chuckhardt/ParkTrainCrossingGuard/CrossingGuardElectSchematic v1.04.pdf

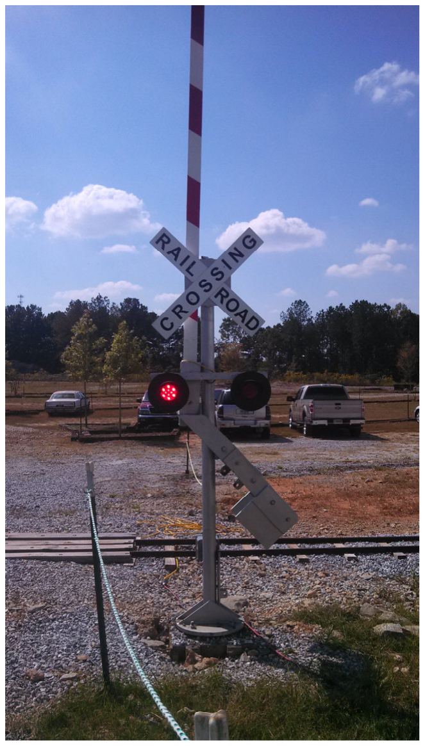
[picture p1: figure]

Park Train Crossing Guard Schematic

Chuck Hardt | 05/08/16 | Rev: 1.04

Crossing Guards – Actuator Motor Operational Notes:
1) The linear actuators that control the up/down movement of the gate arms are protected by limit switches. Power to the drive motor will automatically be cut when the actuator is fully extended (gate down), or fully retracted (gate up).
2) The gate motors are protected from over heating by built in thermal switches. These cannot be manually reset. If the motors overheat, they will automatically be disabled and remain in this state until they cool down. This could leave the gates in the “down” state.
3) The actuator motors are rated at a 10% duty cycle, and cannot run continuously. When lowering or raising the gates, the actuator motor will run for 13 seconds. Thus one complete up and down cycle will total 26 seconds (13 down, 13 up). For every down/up cycle the motors must cool for 260 seconds (4.33 mins).
4) Should the motor duty cycle be exceeded, the motors will be left in the up state, however the lights and bells will continue to function. Once the duty cycle is within normal limits, gate operations will continue.

Crossing Guards – Theory of Operation:
1) Upon first application of power, the control logic will reset. The microcontroller state machine will enter the “initialization” state. The lights and bells will be turned on, the gate motor direction relay will be set to “up”, and the gate motor power control relay will be activated for 13 seconds. After this time, all relays, lights, and bells will be deactivated.
2.0) The gate down/up cycle begins when the track occupation sensor line is pulled low. This line must remain low for 0.5 seconds in order for the micro controller to detect the change, and “trigger” the start of the cycle.
2.1) Upon the “trigger” event, the bells and lights will be activated 3 seconds prior to the gates being lowered.
2.2) The motor direction relay is then set to “down”.
2.3) The motor is activated for 13 seconds. Power to the gate motor will be interrupted (cut off), by the actuator limit switches when the gate arm reaches the max down position.
2.4) The gates will remain in the down position for 30 seconds.
2.5) Should the track occupation sensor “retrigger” during the down/up cycle, the gate down count will reset the 30 second count.
2.6) Once the gates have been down for the max duration, the gate motor control relay will be set to “up”.
2.7) The motor will then be activated for 13 seconds, which will drive the gates to the up position. Power to the gate motor will be interrupted (cut off), by the actuator limit switches when the gate arm reaches the max up position.
2.8) Once the gate arms are in the up position, the lights and bells will be turned off.

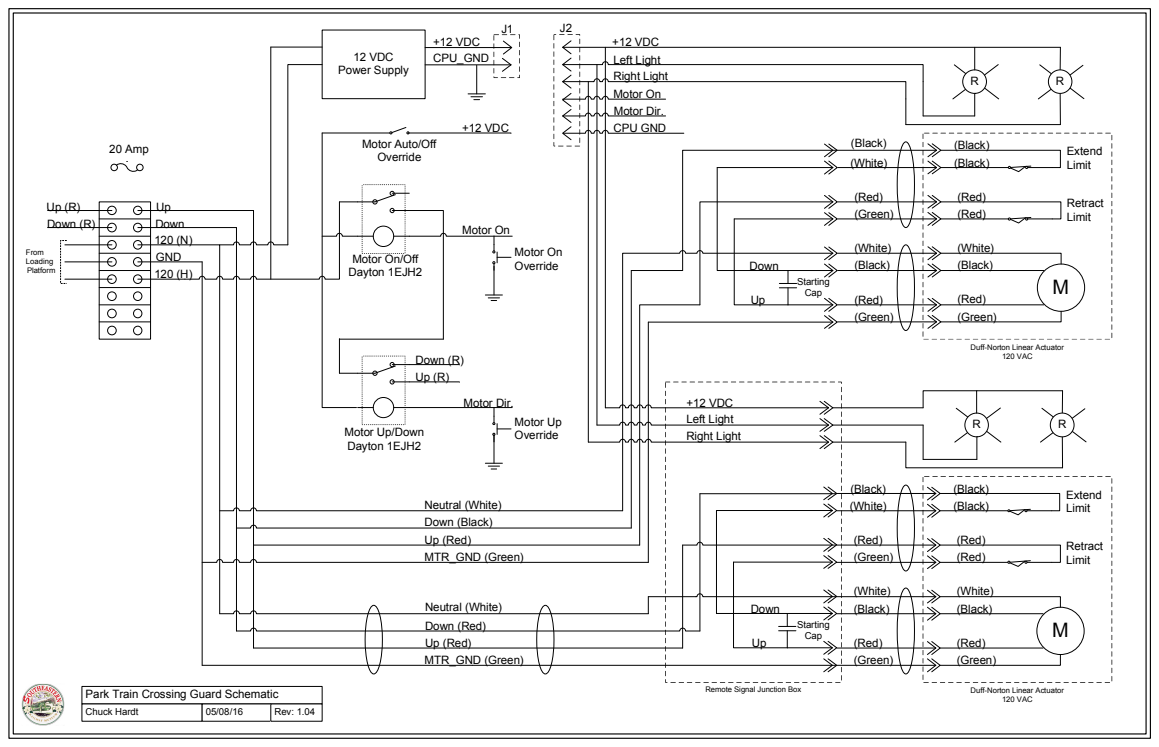
[picture p2: page 2]
120 VAC; (Green); (Red); (Black); (White); Extend Limit; Retract Limit; GND; Down; Neutral (White); Starting Cap; MTR_GND (Green); Down (Black); Up (Red); 12 VDC Power Supply; +12 VDC CPU_GND; +12 VDC; CPU GND; Left Light Right Light; Motor On Override; Motor Up Override; Motor On; Motor Dir.; 20 Amp; Down (Red); Down (R); From Loading Platform

Motor Auto/Off
Override

Motor On/Off
Dayton 1EJH2

Duff-Norton Linear Actuator

Motor Up/Down

Park Train Crossing Guard Schematic

Remote Signal Junction Box

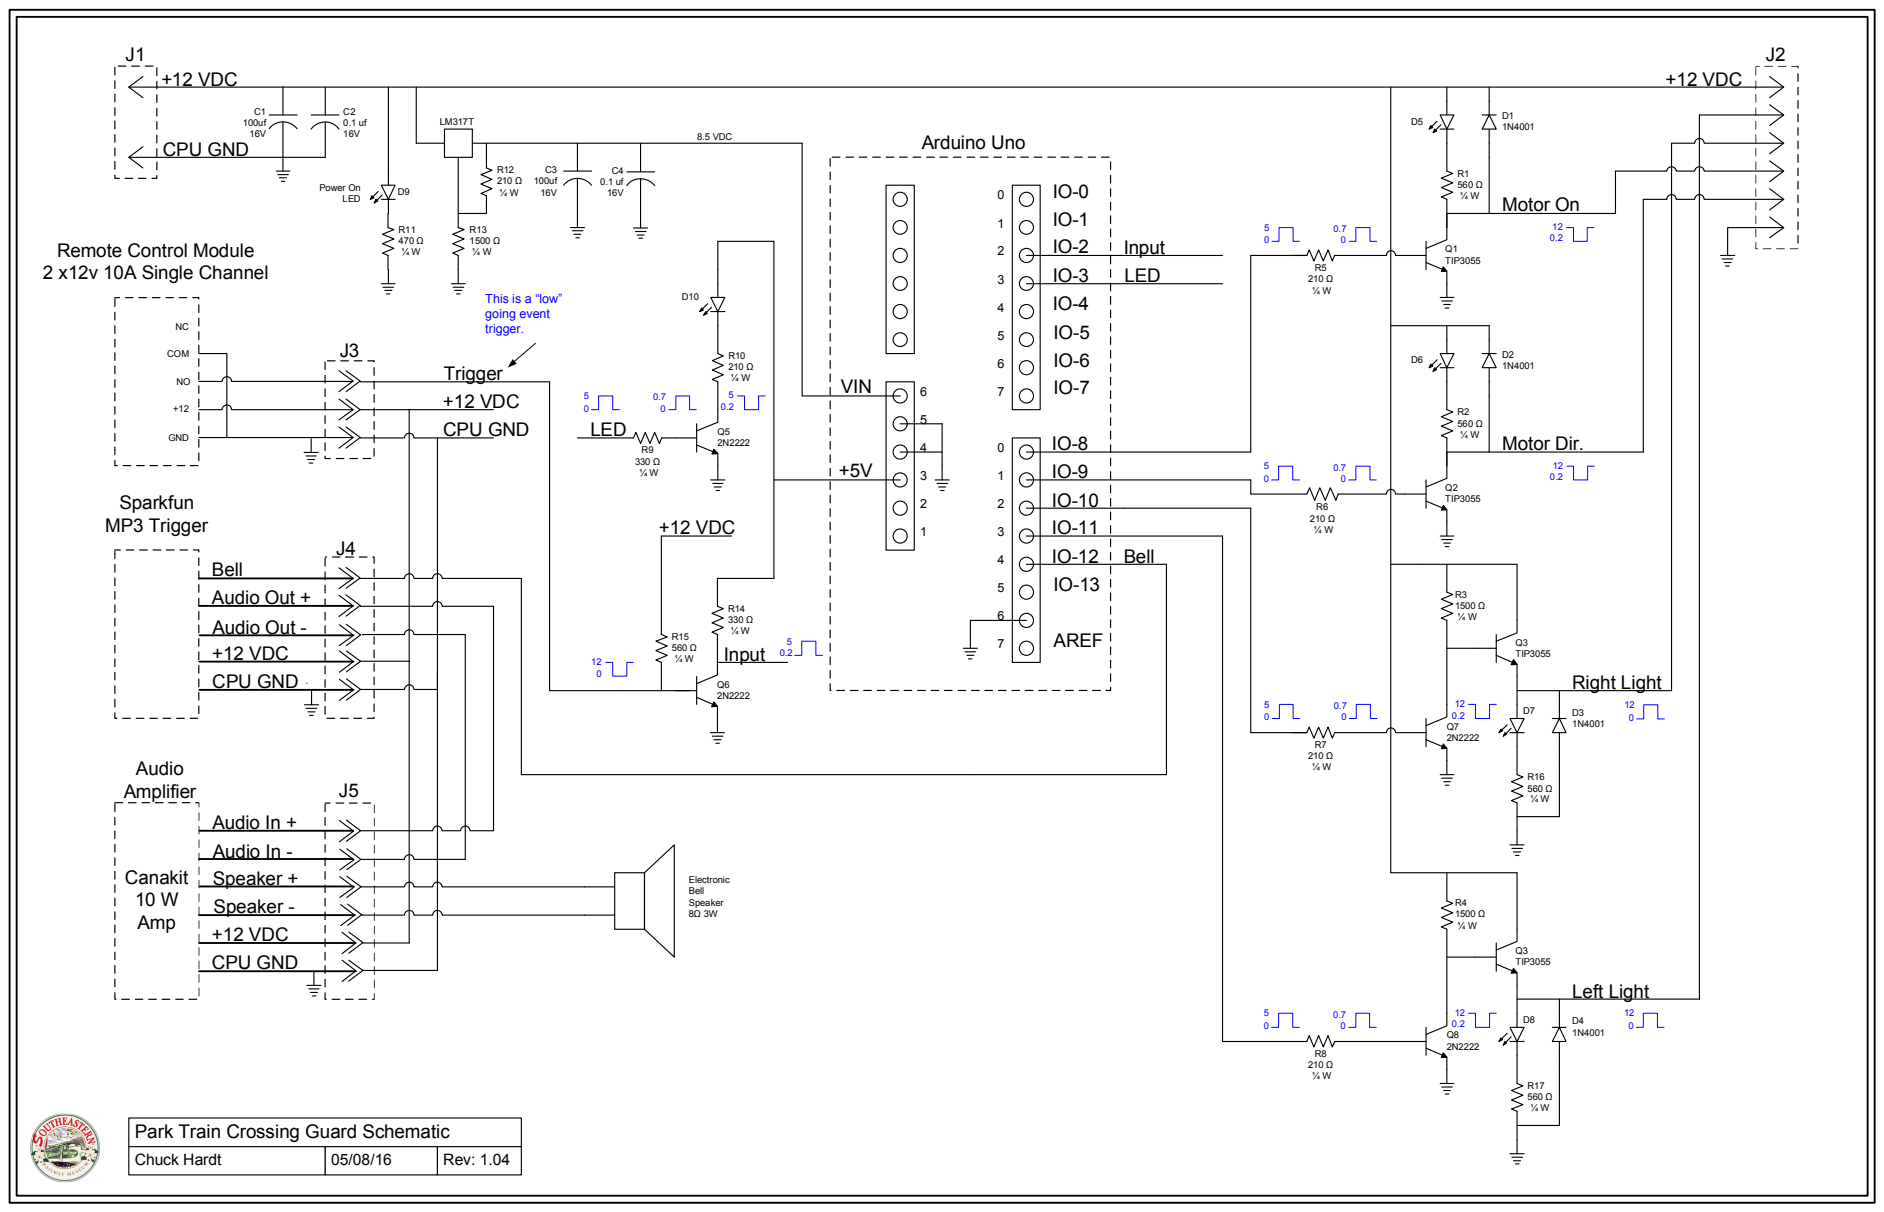
[picture p3: page 3]

Park Train Crossing Guard Schematic

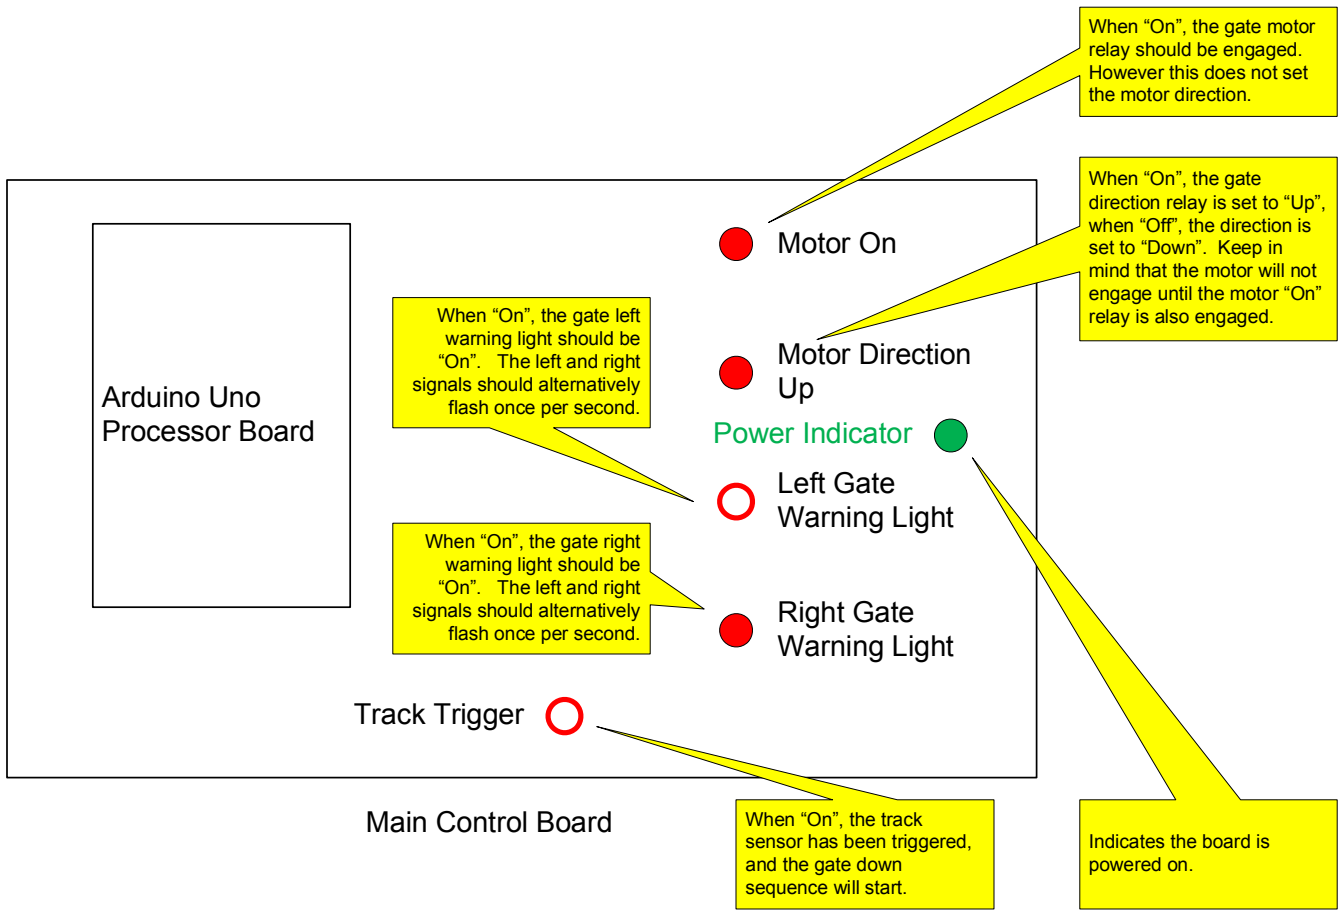
[picture p4: figure]
Arduino Uno Processor Board; Main Control Board; Motor On; Motor Direction Up; Left Gate Warning Light; Right Gate Warning Light; Track Trigger; Power Indicator; When “On”, the gate motor relay should be engaged. However this does not set the motor direction.; When “On”, the gate direction relay is set to “Up”, when “Off”, the direction is set to “Down”. Keep in mind that the motor will not engage until the motor “On”; When “On”, the gate left; relay is also engaged.; warning light should be “On”. The left and right signals should alternatively flash once per second.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

Park Train Crossing Guard Schematic

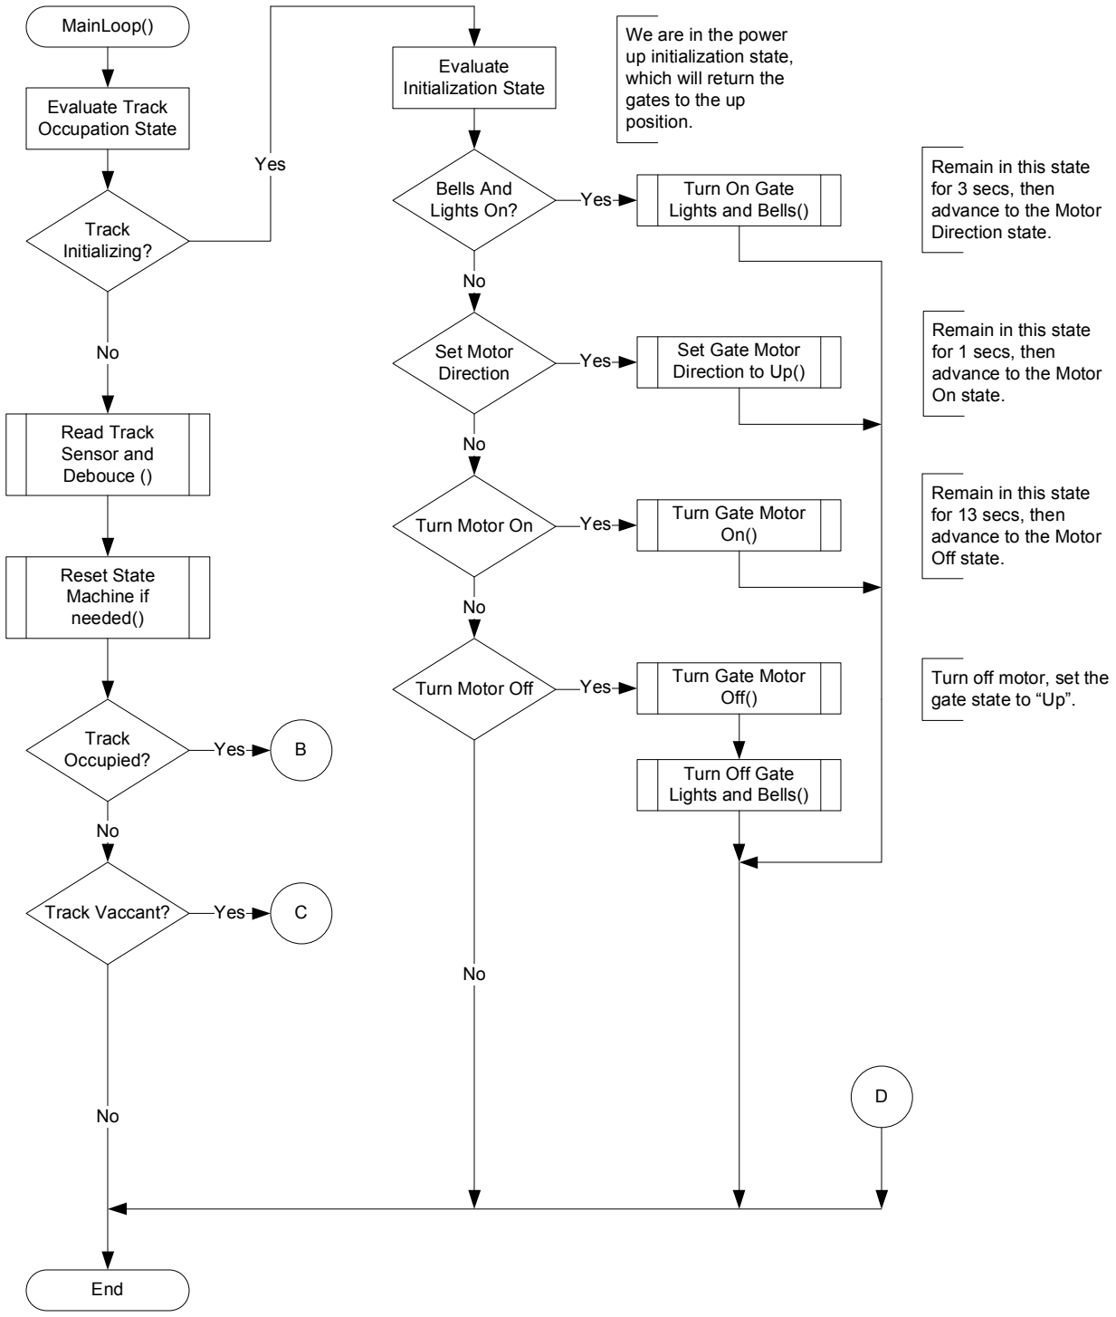
[picture p5: figure]
MainLoop(); Evaluate Track Occupation State; Track Occupied?; Track Vaccant?; End; Track Initializing?; Yes; Evaluate Initialization State; Bells And Lights On?; Set Motor Direction; Turn Motor On; Turn Motor Off; Turn On Gate Lights and Bells(); Set Gate Motor Direction to Up(); Turn Gate Motor On(); Turn Gate Motor Off(); Turn Off Gate Lights and Bells(); Read Track Sensor and Debouce (); Reset State Machine if needed(); Remain in this state for 3 secs, then advance to the Motor Direction state.; Remain in this state for 1 secs, then advance to the Motor On state.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

Park Train Crossing Guard Schematic

Start

The state machine
uses an event timer.
MainLoop() will be
called every 250ms.

Initialize All I/O
Pins

Initialize All State
Machine Variables

Start the
MainLoop()
Event Timer

The track sensor must
read the same value
over 500ms.

We may need to reset
the state machine.

### Micro Controller Software Flowchart

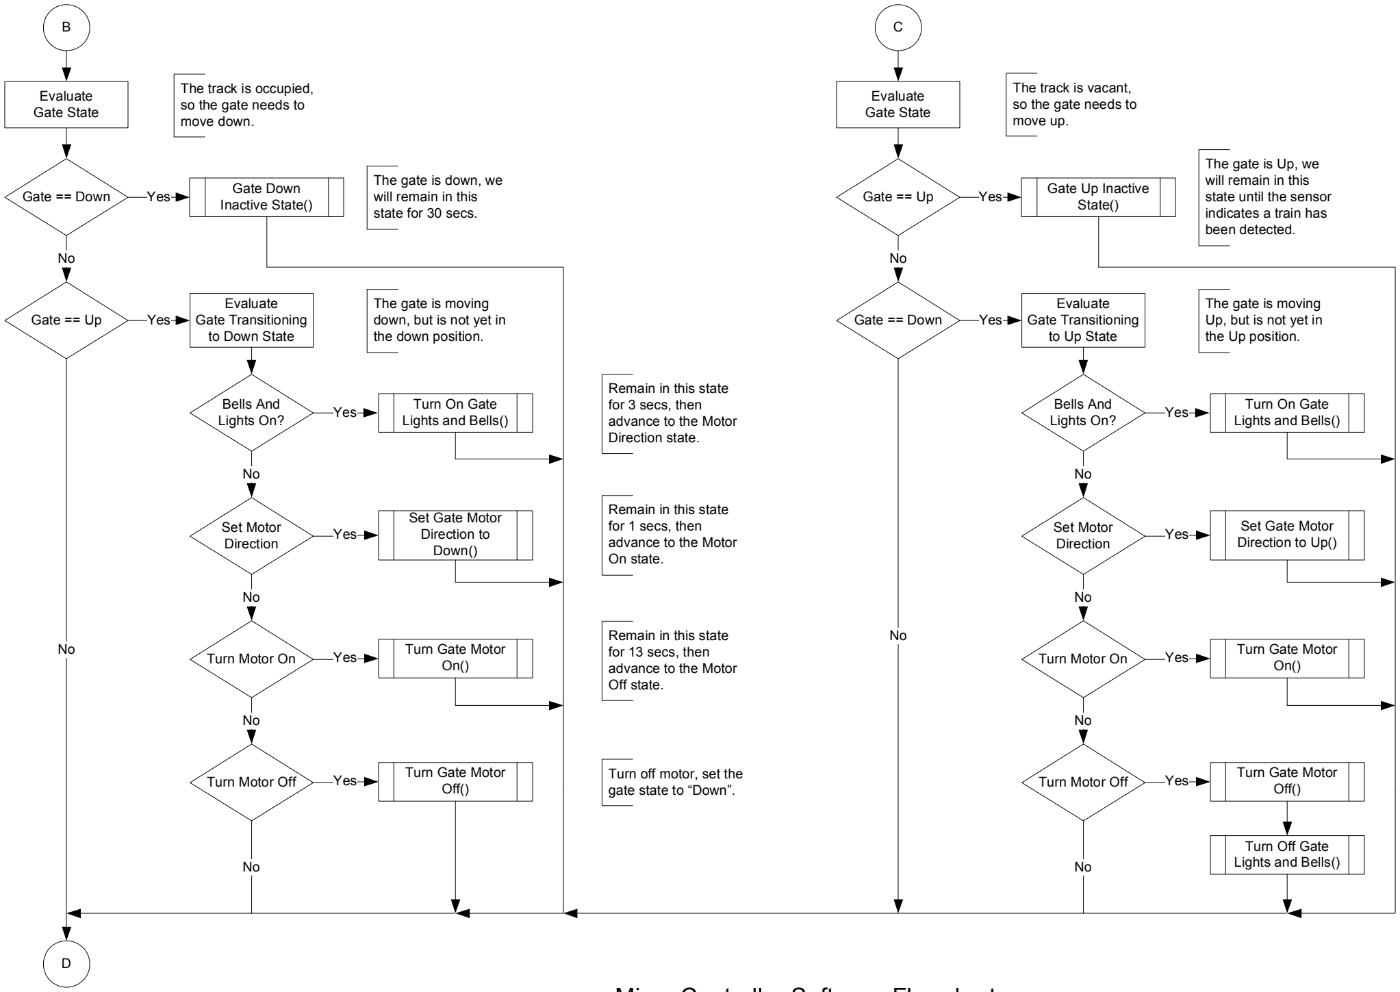
[picture p6: figure]
Evaluate Gate State; Gate == Down; Gate == Up; Yes; Gate Down Inactive State(); Evaluate Gate Transitioning to Down State; Bells And Lights On?; Set Motor Direction; Turn Motor On; Turn Motor Off; Turn On Gate Lights and Bells(); Set Gate Motor Direction to Down(); Turn Gate Motor On(); Turn Gate Motor Off(); The gate is down, we will remain in this state for 30 secs.; Remain in this state for 3 secs, then advance to the Motor Direction state.; Remain in this state for 1 secs, then advance to the Motor On state.; Remain in this state for 13 secs, then advance to the Motor Off state.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

Park Train Crossing Guard Schematic

Remain in this state
for 3 secs, then
advance to the Motor
Direction state.

Remain in this state
for 1 secs, then
advance to the Motor
On state.

Remain in this state
for 13 secs, then
advance to the Motor
Off state.

Turn off motor, set the
gate state to “Up”.

### Micro Controller Software Flowchart
