chuckhardt/ParkTrainCrossingGuard/Timer.cpp

/*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
 *      You should have received a copy of the GNU General Public License
 *      along with this program; if not, write to the Free Software
 *      Foundation, Inc., 51 Franklin Street, Fifth Floor, Boston,
 *      MA 02110-1301, USA.
 */

/*  * * * * * * * * * * * * * * * * * * * * * * * * * * *
 Code by Simon Monk
 http://www.simonmonk.org
* * * * * * * * * * * * * * * * * * * * * * * * * * * * */

// For Arduino 1.0 and earlier
#if defined(ARDUINO) && ARDUINO >= 100
#include "Arduino.h"
#else
#include "WProgram.h"
#endif

#include "Timer.h"

Timer::Timer(void)
{
}

int8_t Timer::every(unsigned long period, void (*callback)(), int repeatCount)
{
	int8_t i = findFreeEventIndex();
	if (i == -1) return -1;

        Serial.print("Timer Start: ");
        Serial.println(i);

	_events[i].eventType = EVENT_EVERY;
	_events[i].period = period;
	_events[i].repeatCount = repeatCount;
	_events[i].callback = callback;
	_events[i].lastEventTime = millis();
	_events[i].count = 0;
	return i;
}

int8_t Timer::every(unsigned long period, void (*callback)())
{
	return every(period, callback, -1); // - means forever
}

int8_t Timer::after(unsigned long period, void (*callback)())
{
	return every(period, callback, 1);
}

int8_t Timer::oscillate(uint8_t pin, unsigned long period, uint8_t startingValue, int repeatCount)
{
	int8_t i = findFreeEventIndex();
	if (i == -1) return -1;

	_events[i].eventType = EVENT_OSCILLATE;
	_events[i].pin = pin;
	_events[i].period = period;
	_events[i].pinState = startingValue;
	digitalWrite(pin, startingValue);
	_events[i].repeatCount = repeatCount * 2; // full cycles not transitions
	_events[i].lastEventTime = millis();
	_events[i].count = 0;
	return i;
}

int8_t Timer::oscillate(uint8_t pin, unsigned long period, uint8_t startingValue)
{
	return oscillate(pin, period, startingValue, -1); // forever
}

int8_t Timer::pulse(uint8_t pin, unsigned long period, uint8_t startingValue)
{
	return oscillate(pin, period, startingValue, 1); // once
}

void Timer::stop(int8_t id)
{
       //Serial.print("Timer: ");
       //Serial.print(id);
       //Serial.print(" Was: ");
       //Serial.println(_events[id].eventType);
       
       // verify that the timer was in use, if not print an error
       if (_events[id].eventType == EVENT_NONE)
       {
           Serial.print("Timer Stop Error: ");
           Serial.println(id);
       }  
       _events[id].eventType = EVENT_NONE;
        
}

void Timer::update(void)
{
	for (int8_t i = 0; i < MAX_NUMBER_OF_EVENTS; i++)
	{
		if (_events[i].eventType != EVENT_NONE)
		{
			_events[i].update();
		}
	}
}

int8_t Timer::findFreeEventIndex(void)
{
	for (int8_t i = 0; i < MAX_NUMBER_OF_EVENTS; i++)
	{
		if (_events[i].eventType == EVENT_NONE)
		{
			return i;
		}
	}
	return -1;
}
